KMuriungi/Kithinji-Muriungi-Drone-Project---Final-Year-Engineering-Project/Images/Drone App 53.jpeg

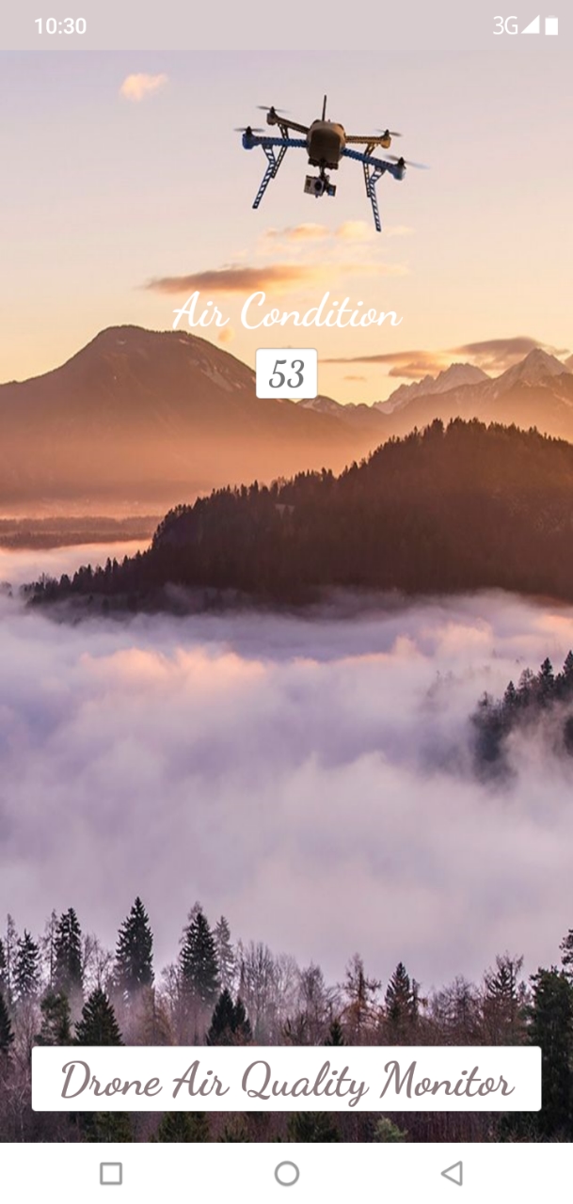
Images/Drone App 53.jpeg
