KMuriungi/Kithinji-Muriungi-Drone-Project---Final-Year-Engineering-Project/Images/Ki.jpg

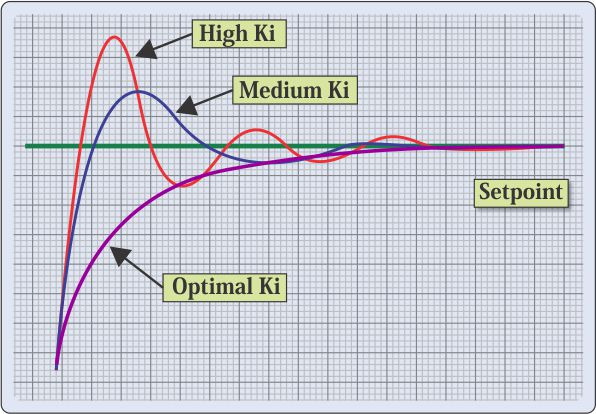
Images/Ki.jpg
