KMuriungi/Kithinji-Muriungi-Drone-Project---Final-Year-Engineering-Project/README.md

# Kithinji-Muriungi-Drone-Project---Final-Year-Engineering-Project

BEng (Electrical & Electronics Engineering)

/*ECE 590: ENGINEERING PROJECT II      
MULTI-PURPOSE QUADCOPTER     
: Arduino Based PID Controller     
EC/09/14  

KITHINJI MURIUNGI  
<WhatsApp: +254718605065, 
Email: kithinjimuriungi@yahoo.com,
https://www.linkedin.com/in/kithinjimuriungi/>  

2018/19     
Supervisor: Mr. S.B.Kifalu */
