KMuriungi/Kithinji-Muriungi-Drone-Project---Final-Year-Engineering-Project/EC-09-14 ECE590 Final Presentation.pdf

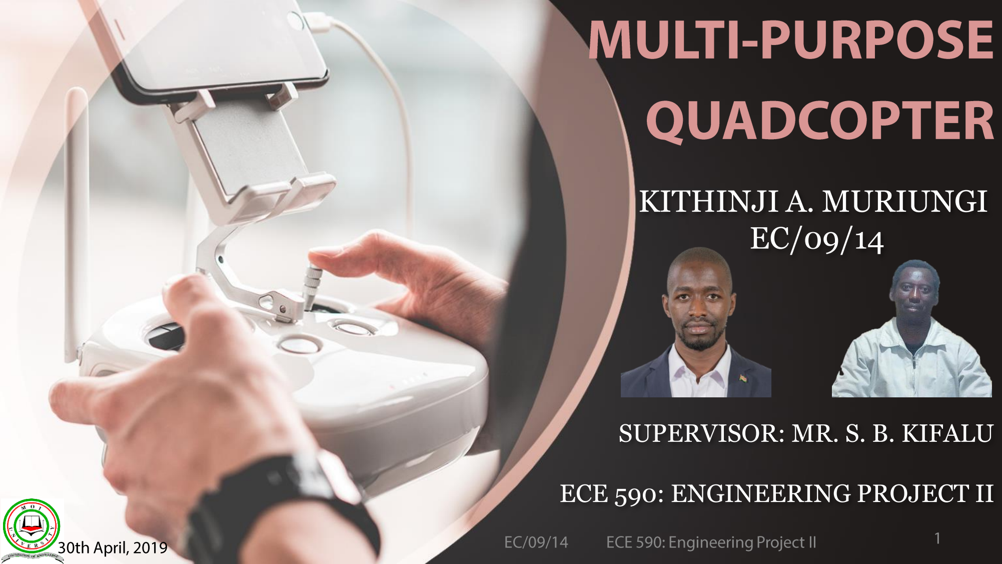
[picture p75: page 1]

KITHINJI A. MURIUNGI
EC/09/14

SUPERVISOR: MR. S. B. KIFALU

ECE 590: ENGINEERING PROJECT II

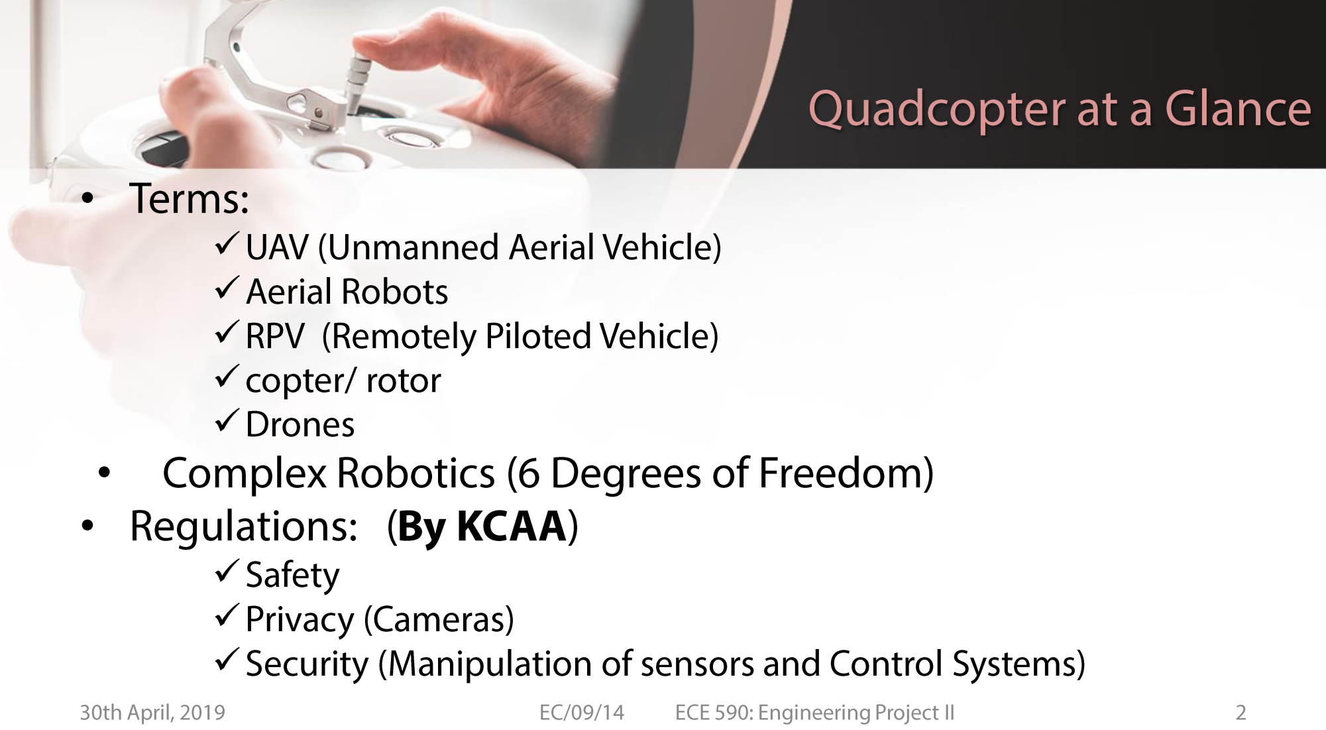
[picture p76: page 2]

•
✓✓✓✓✓

•
•

✓✓✓

- Basic Mechanics (6D of Freedom)
- Design Considerations (Weight, Power, Energy, Mass Distribution)
- Agility (Efficiency and Optimization)
- Components Selection (Frame, Motors & Propellers, Controllers, etc)
- Controls : PID (Height, Thrust)
- Effect of Size and mass
- Applications: IoT-Based

- Surveillance and Border Patrol
- Search and Rescue

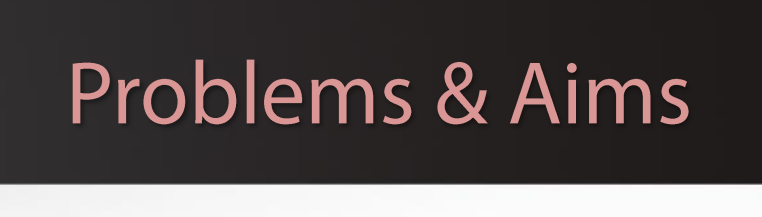
[picture p77: figure]

- First and fast respondent (Danger)
- Access to the most remote and harsh areas
- Expensive and Specific purposed quadcopters
- Manipulation of the existing designs

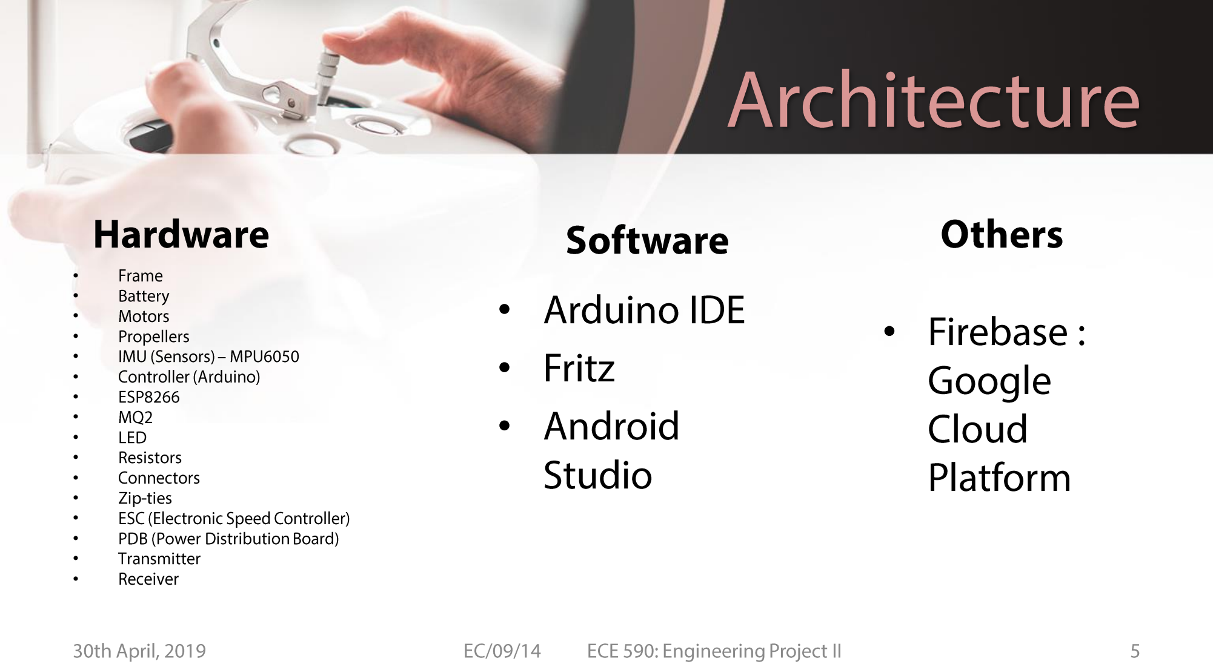
[picture p78: page 5]

••••••••••••••••
•••
•

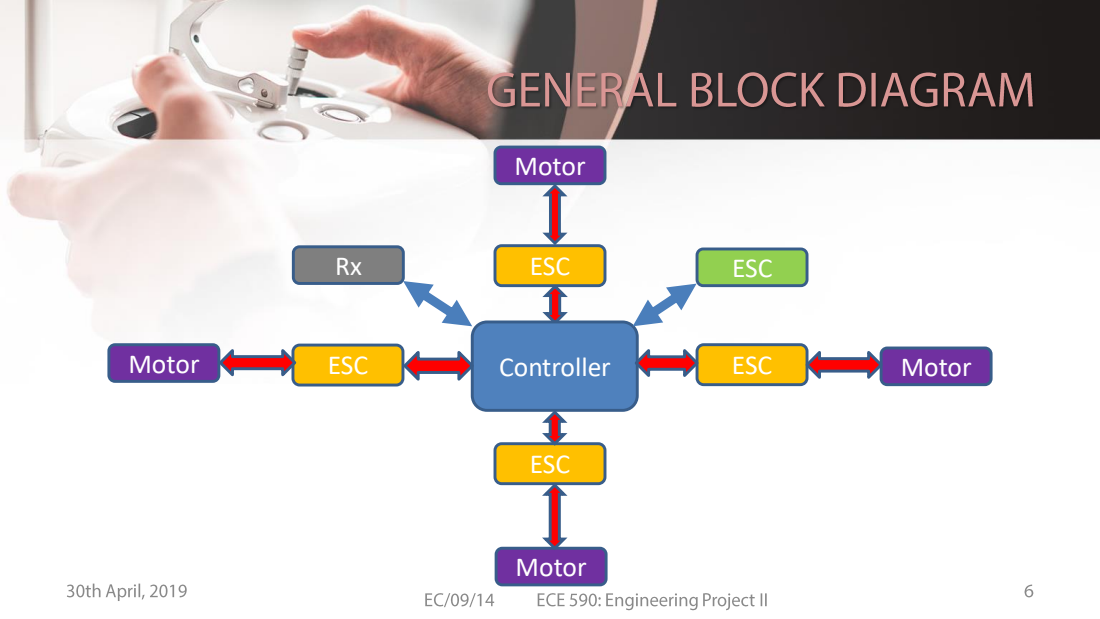
[picture p79: page 6]
ESC; Motor; Controller

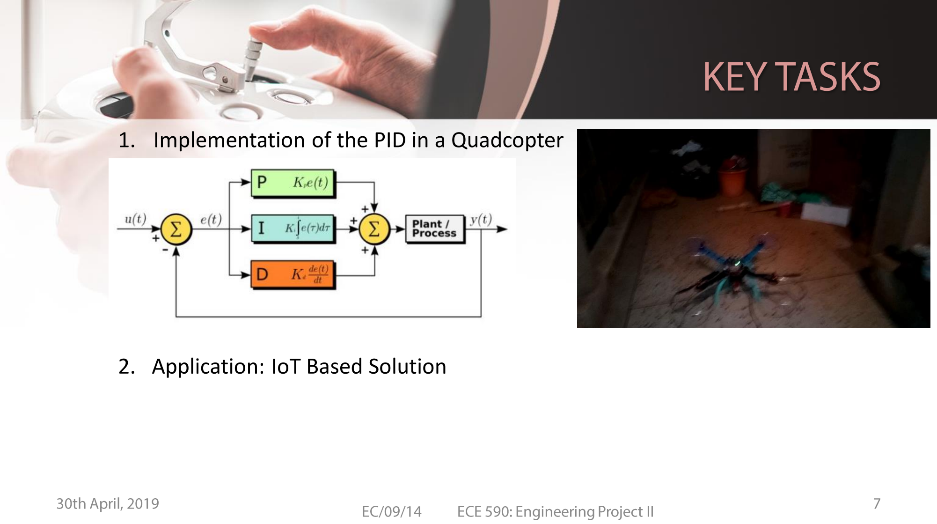
[picture p80: page 7]

1. Implementation of the PID in a Quadcopter
2. Application: IoT Based Solution

- Design Manipulation.
- Precision Building.
- Complex Design Controls.

- Delay of the project.

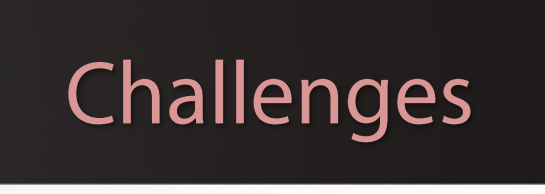
[picture p81: figure]

- Faulty IMU makes it hard in controls.
- Power Problems.
- Obtaining a precise Balanced System.
- Very expensive project.
- Big Scope for one person.

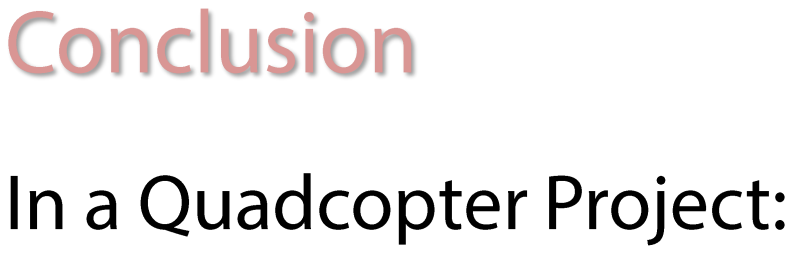
[picture p82: figure]

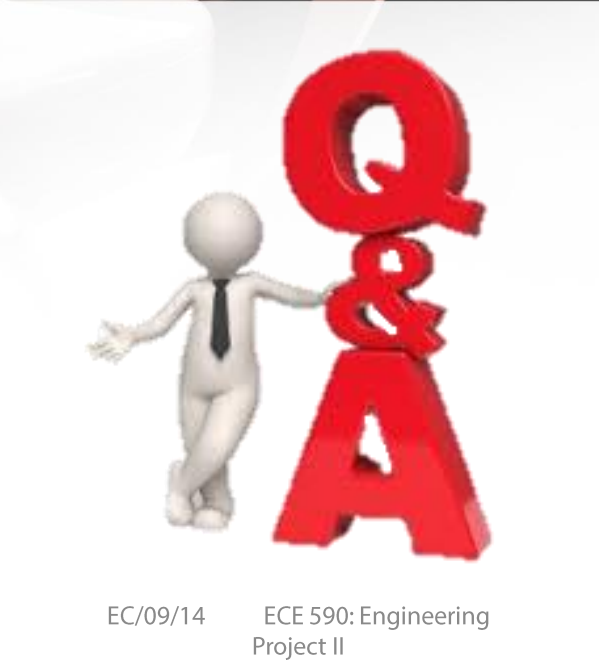
[picture p83: figure]
