KMuriungi/Kithinji-Muriungi-Drone-Project---Final-Year-Engineering-Project/KCAA License.pdf

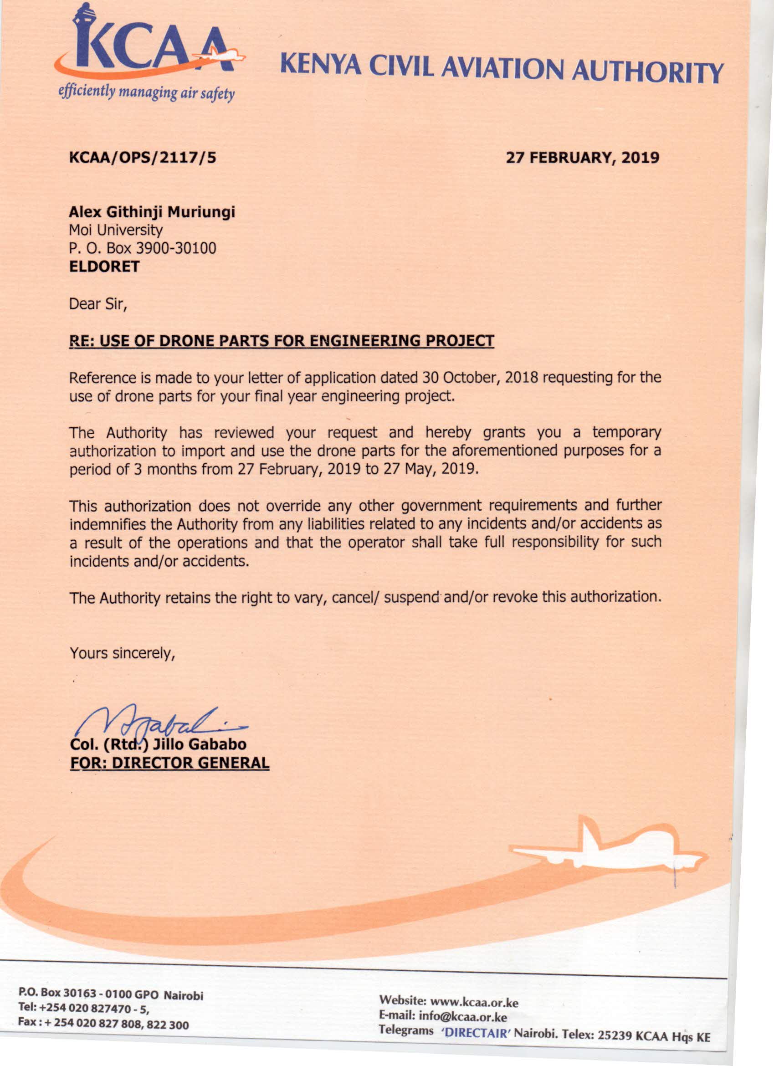
[picture p84: page 1]
