KMuriungi/Kithinji-Muriungi-Drone-Project---Final-Year-Engineering-Project/Images/algorithms/Best Quadcopter Report_017.png

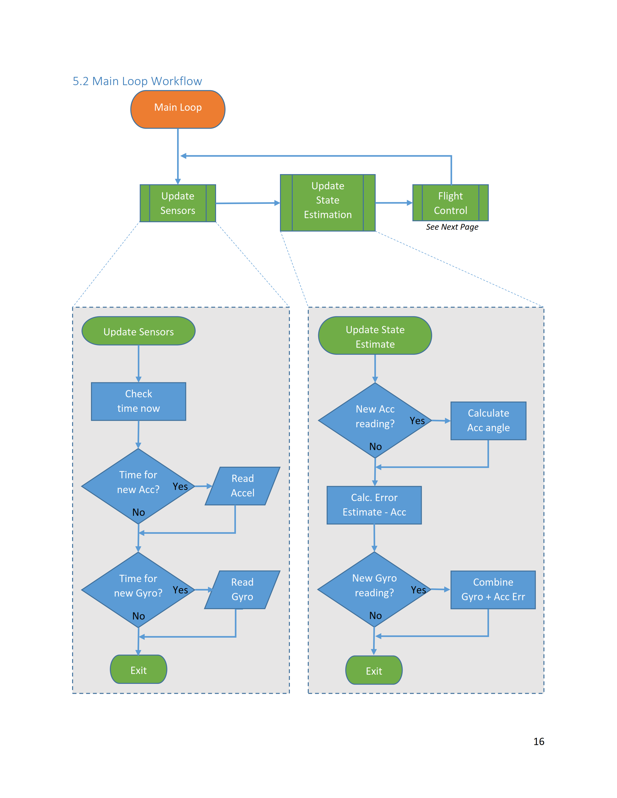
Images/algorithms/Best Quadcopter Report_017.png
