KMuriungi/Kithinji-Muriungi-Drone-Project---Final-Year-Engineering-Project/Images/algorithms/Best Quadcopter Report_019.png

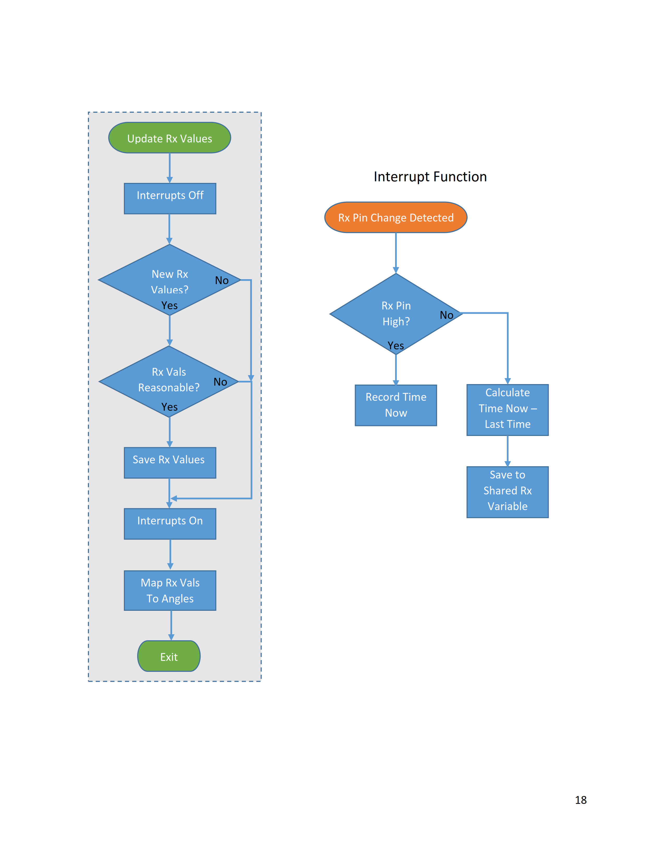
Images/algorithms/Best Quadcopter Report_019.png
