KMuriungi/Kithinji-Muriungi-Drone-Project---Final-Year-Engineering-Project/Images/arducopter.jpg

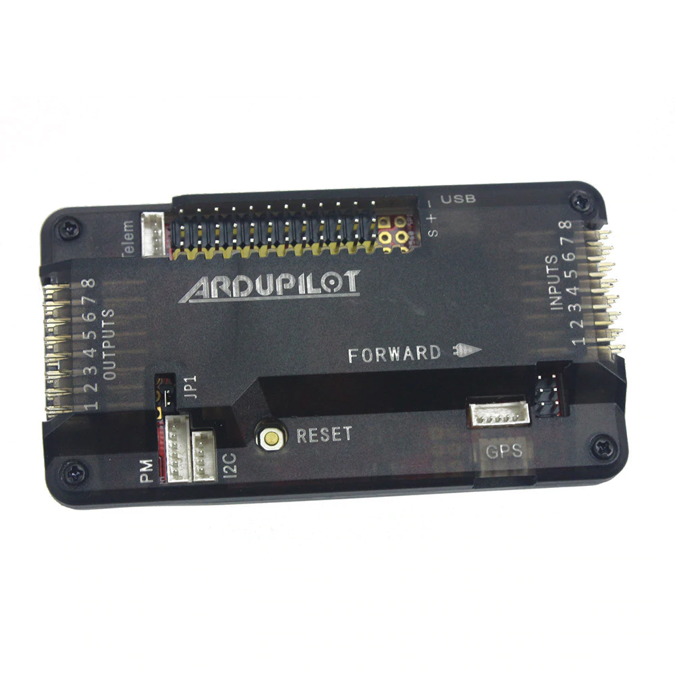
Images/arducopter.jpg
