KMuriungi/Kithinji-Muriungi-Drone-Project---Final-Year-Engineering-Project/Images/arduino uno.jpg

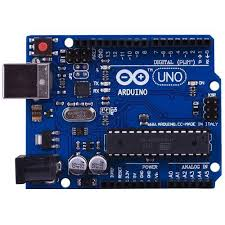
Images/arduino uno.jpg
