KMuriungi/Kithinji-Muriungi-Drone-Project---Final-Year-Engineering-Project/Images/ardupilot.jpg

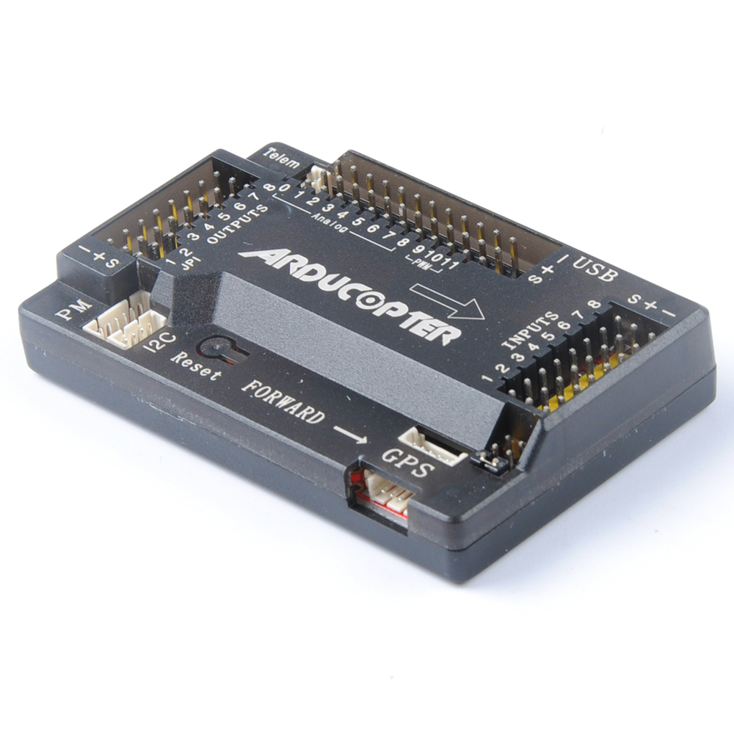
Images/ardupilot.jpg
