KMuriungi/Kithinji-Muriungi-Drone-Project---Final-Year-Engineering-Project/Images/code flow.png

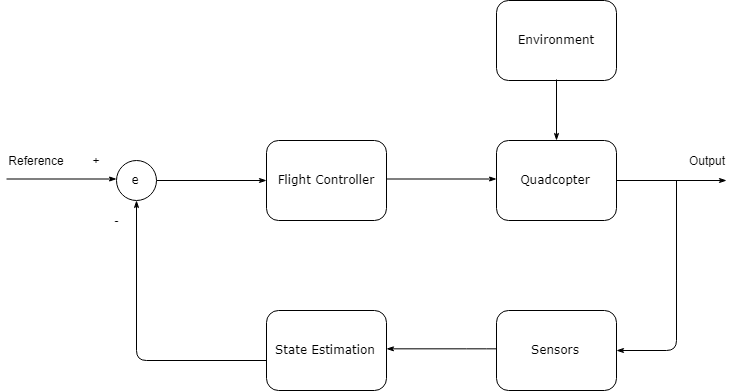
Images/code flow.png
