KMuriungi/Kithinji-Muriungi-Drone-Project---Final-Year-Engineering-Project/Images/esc.jpg

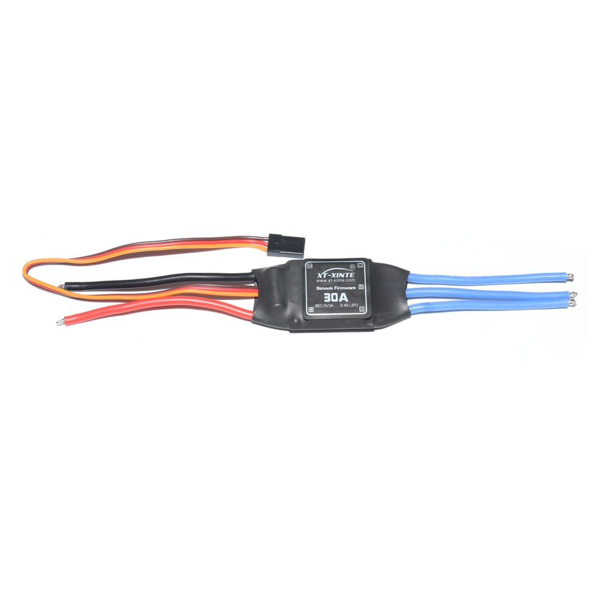
Images/esc.jpg
