KMuriungi/Kithinji-Muriungi-Drone-Project---Final-Year-Engineering-Project/Images/esp8266 fritz.png

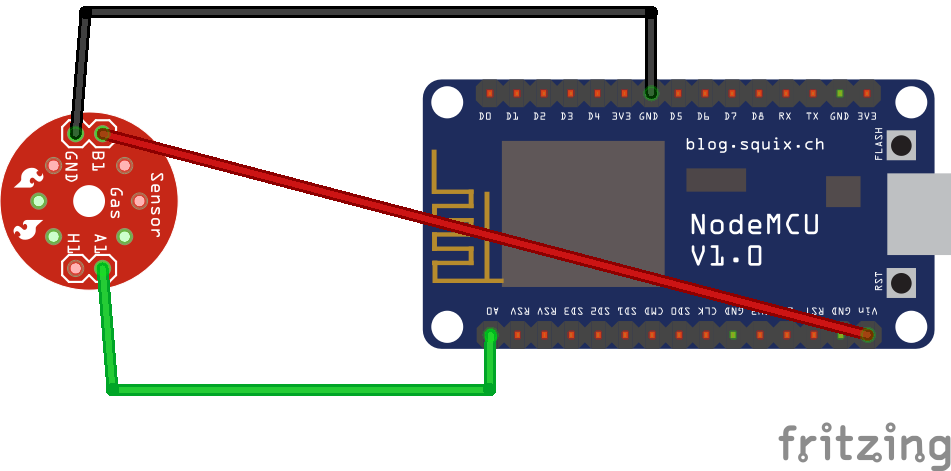
Images/esp8266 fritz.png
