KMuriungi/Kithinji-Muriungi-Drone-Project---Final-Year-Engineering-Project/Images/flysky transmitter.jpg

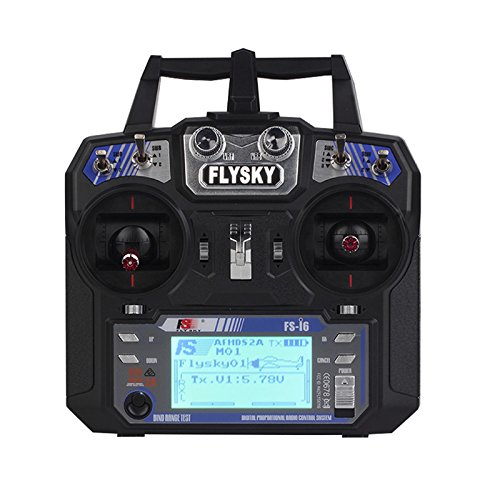
Images/flysky transmitter.jpg
