KMuriungi/Kithinji-Muriungi-Drone-Project---Final-Year-Engineering-Project/Images/frame whole.jpg

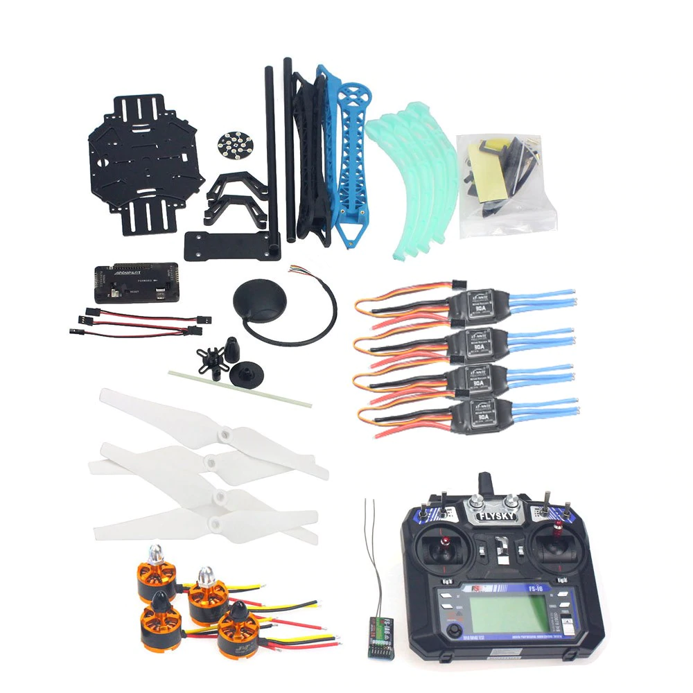
Images/frame whole.jpg
