KMuriungi/Kithinji-Muriungi-Drone-Project---Final-Year-Engineering-Project/Images/kp kd.jpg

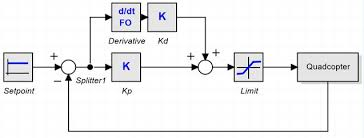
Images/kp kd.jpg
