KMuriungi/Kithinji-Muriungi-Drone-Project---Final-Year-Engineering-Project/Images/MPU-6050 Arduino_bb.png

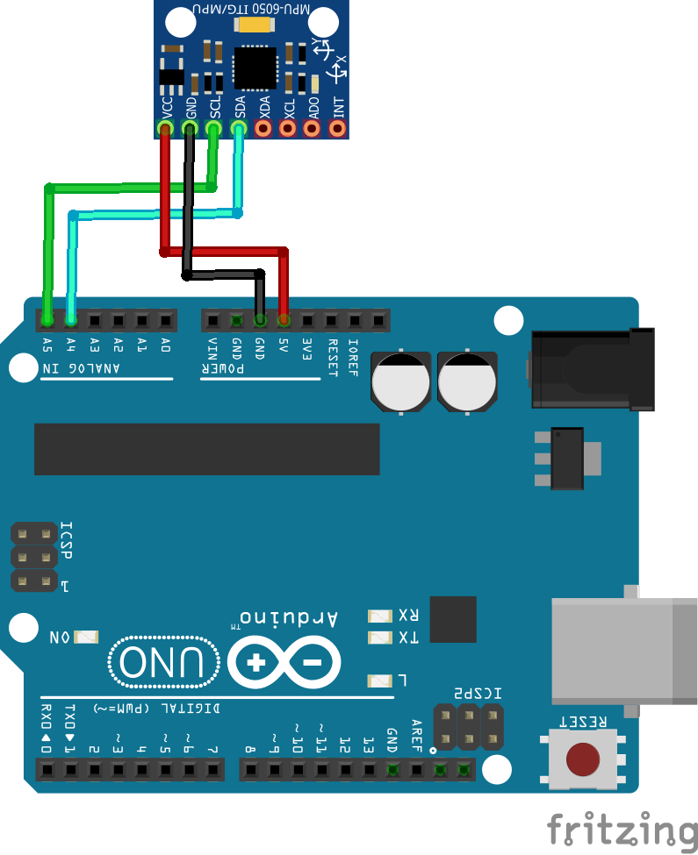
Images/MPU-6050 Arduino_bb.png
