KMuriungi/Kithinji-Muriungi-Drone-Project---Final-Year-Engineering-Project/Images/mq2-sensor.png

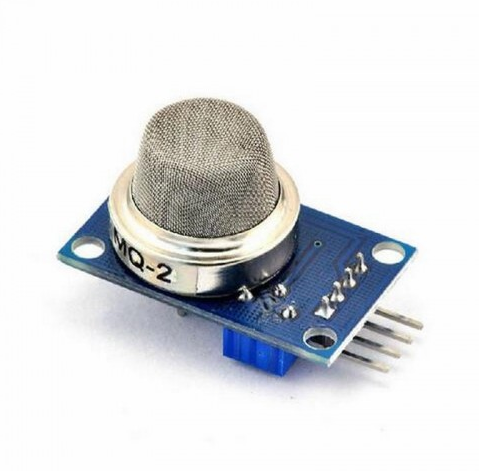
Images/mq2-sensor.png
