KMuriungi/Kithinji-Muriungi-Drone-Project---Final-Year-Engineering-Project/Images/pd flow.png

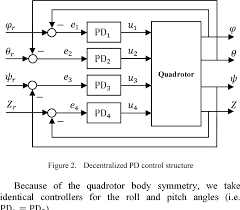
Images/pd flow.png
