KMuriungi/Kithinji-Muriungi-Drone-Project---Final-Year-Engineering-Project/Images/pd height control 3 color.jpg

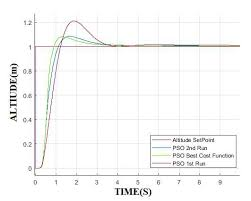
Images/pd height control 3 color.jpg
