KMuriungi/Kithinji-Muriungi-Drone-Project---Final-Year-Engineering-Project/Images/pd height control.png

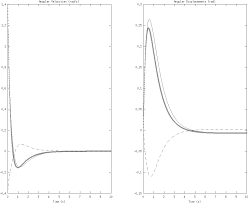
Images/pd height control.png
