KMuriungi/Kithinji-Muriungi-Drone-Project---Final-Year-Engineering-Project/Images/PLAGIARISM.PNG

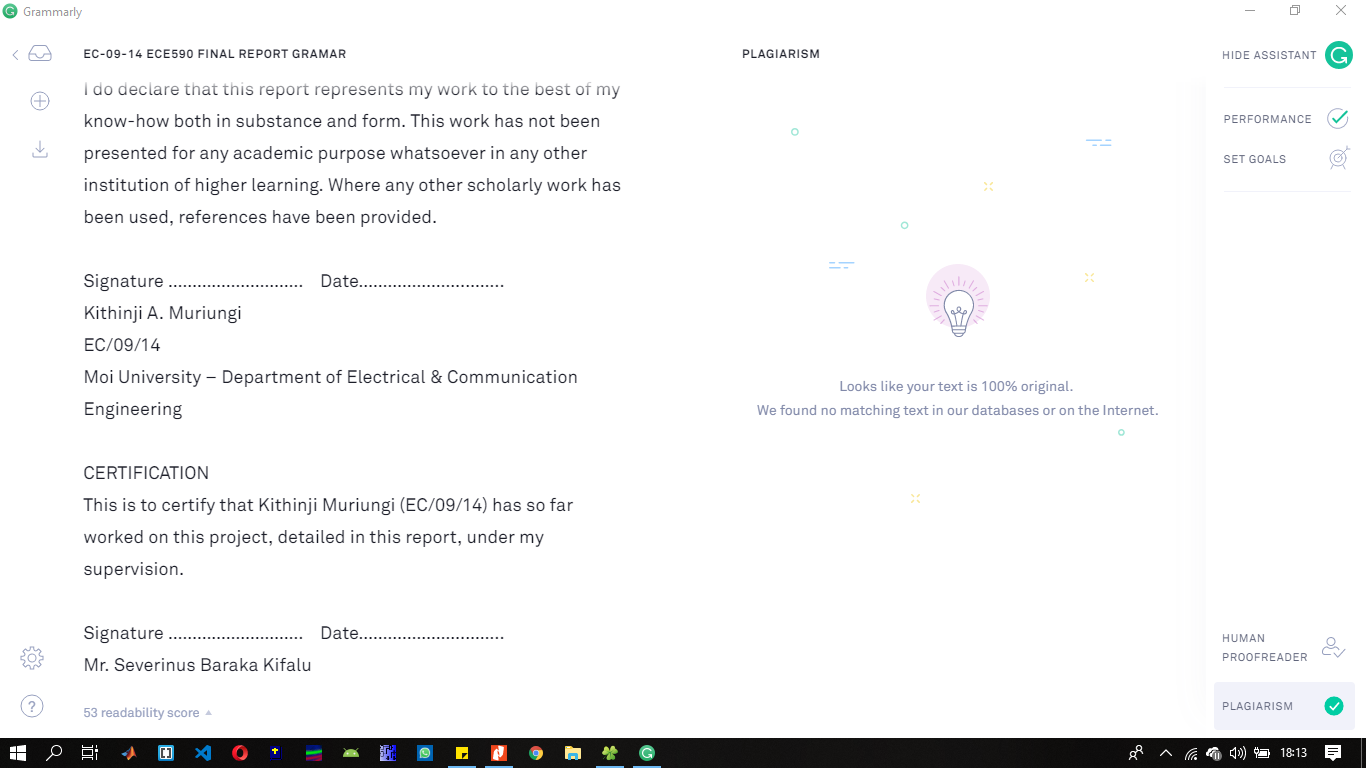
Images/PLAGIARISM.PNG
