KMuriungi/Kithinji-Muriungi-Drone-Project---Final-Year-Engineering-Project/Images/Quad fritz_bb.png

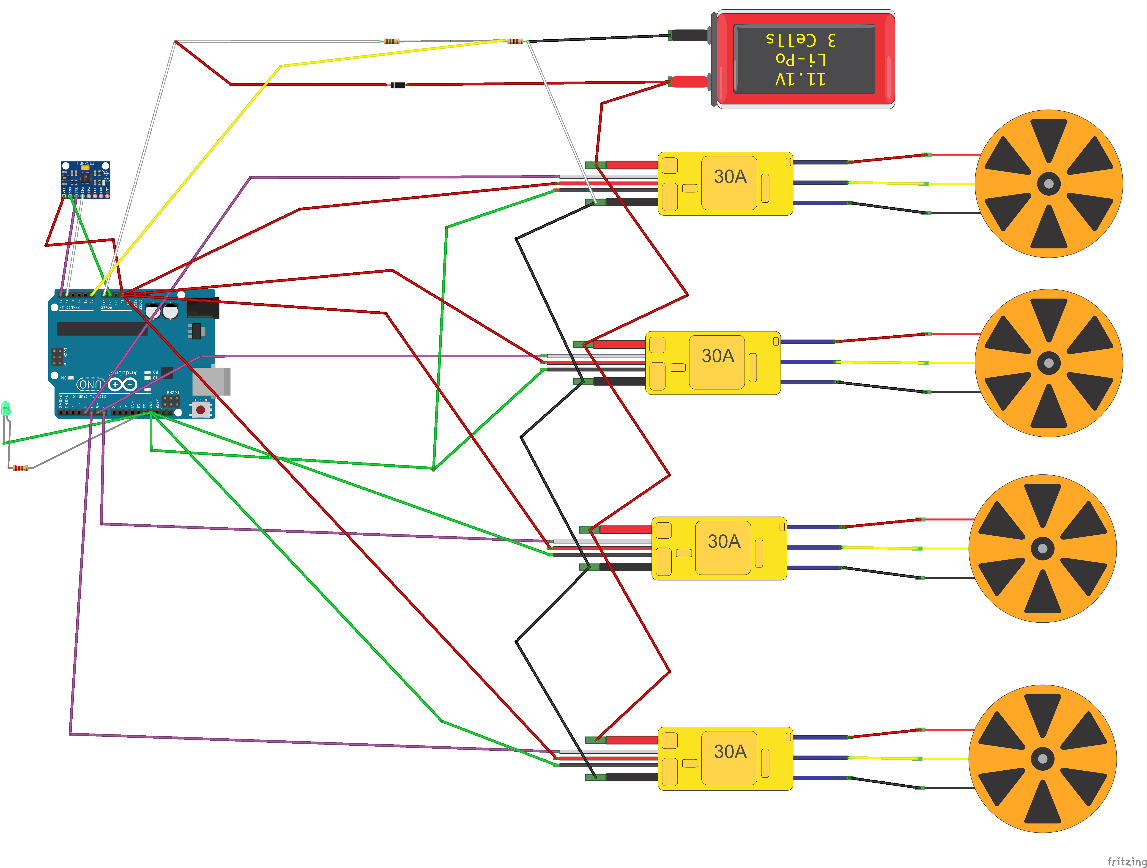
Images/Quad fritz_bb.png
