KMuriungi/Kithinji-Muriungi-Drone-Project---Final-Year-Engineering-Project/Images/quadcopter-propeller-thrust.png

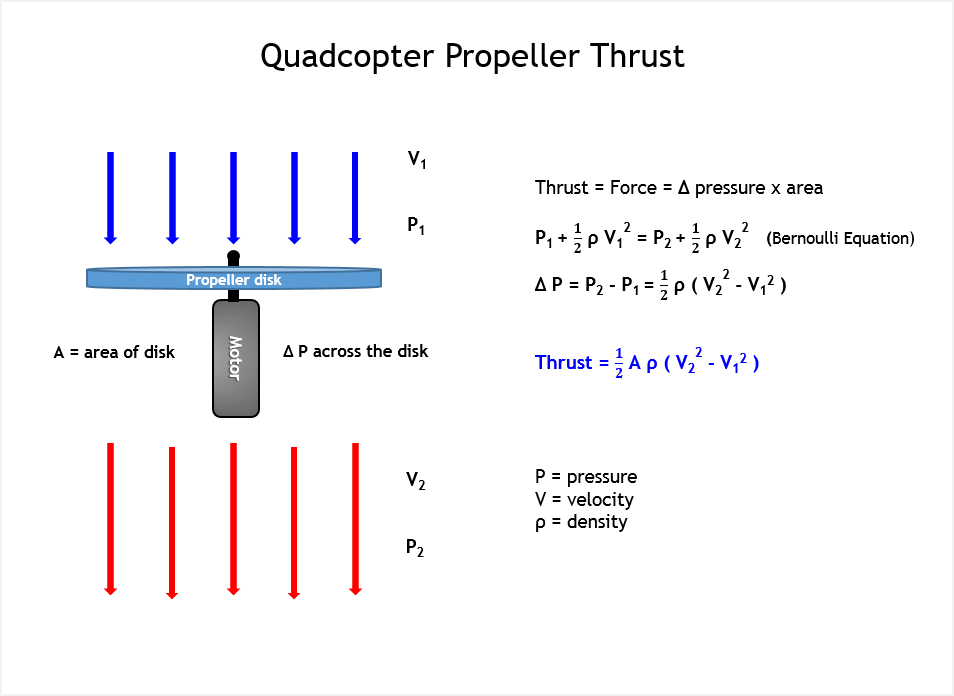
Images/quadcopter-propeller-thrust.png
