KMuriungi/Kithinji-Muriungi-Drone-Project---Final-Year-Engineering-Project/Images/rx tx.jpg

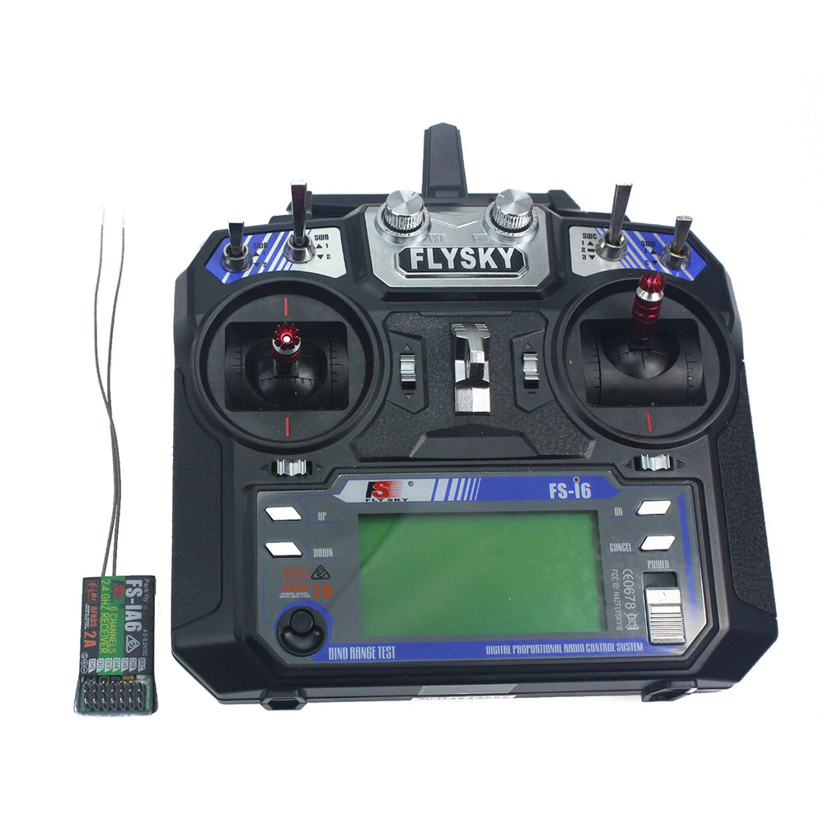
Images/rx tx.jpg
