KMuriungi/Kithinji-Muriungi-Drone-Project---Final-Year-Engineering-Project/Images/schedule.PNG

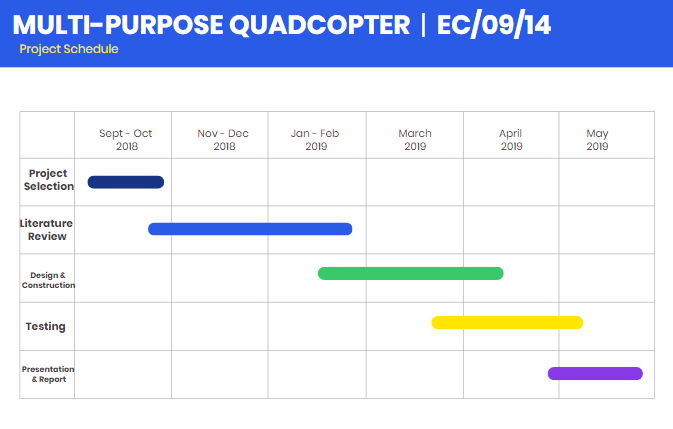
Images/schedule.PNG
