KMuriungi/Kithinji-Muriungi-Drone-Project---Final-Year-Engineering-Project/Images/thrust to weight.png

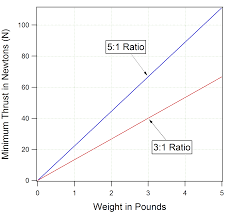
Images/thrust to weight.png
