KMuriungi/Kithinji-Muriungi-Drone-Project---Final-Year-Engineering-Project/Images/thrust weight.jpg

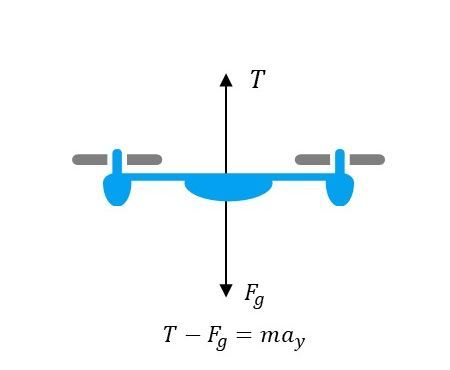
Images/thrust weight.jpg
