KMuriungi/Kithinji-Muriungi-Drone-Project---Final-Year-Engineering-Project/Images/thrust,yaw, roll,pitch.png

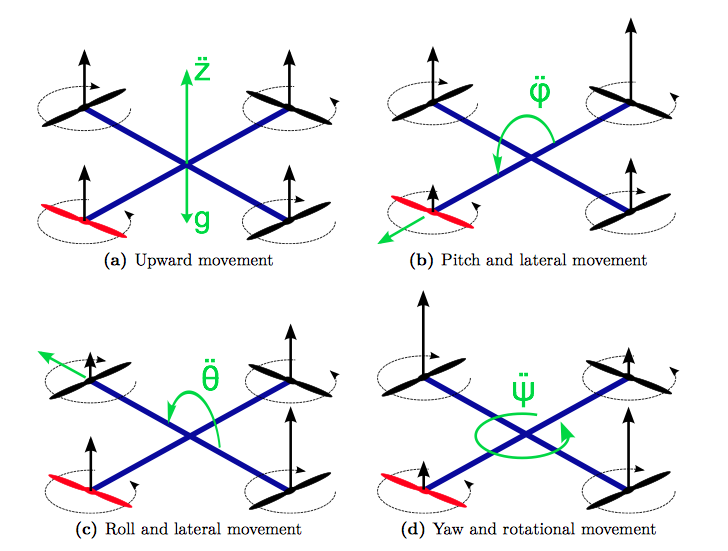
Images/thrust,yaw, roll,pitch.png
