KMuriungi/Kithinji-Muriungi-Drone-Project---Final-Year-Engineering-Project/My Report Resources/Gyro Pitch Error 0001.JPG

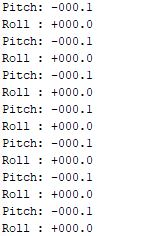
My Report Resources/Gyro Pitch Error 0001.JPG
