KMuriungi/Kithinji-Muriungi-Drone-Project---Final-Year-Engineering-Project/My Report Resources/firebase Arduino Setup.JPG

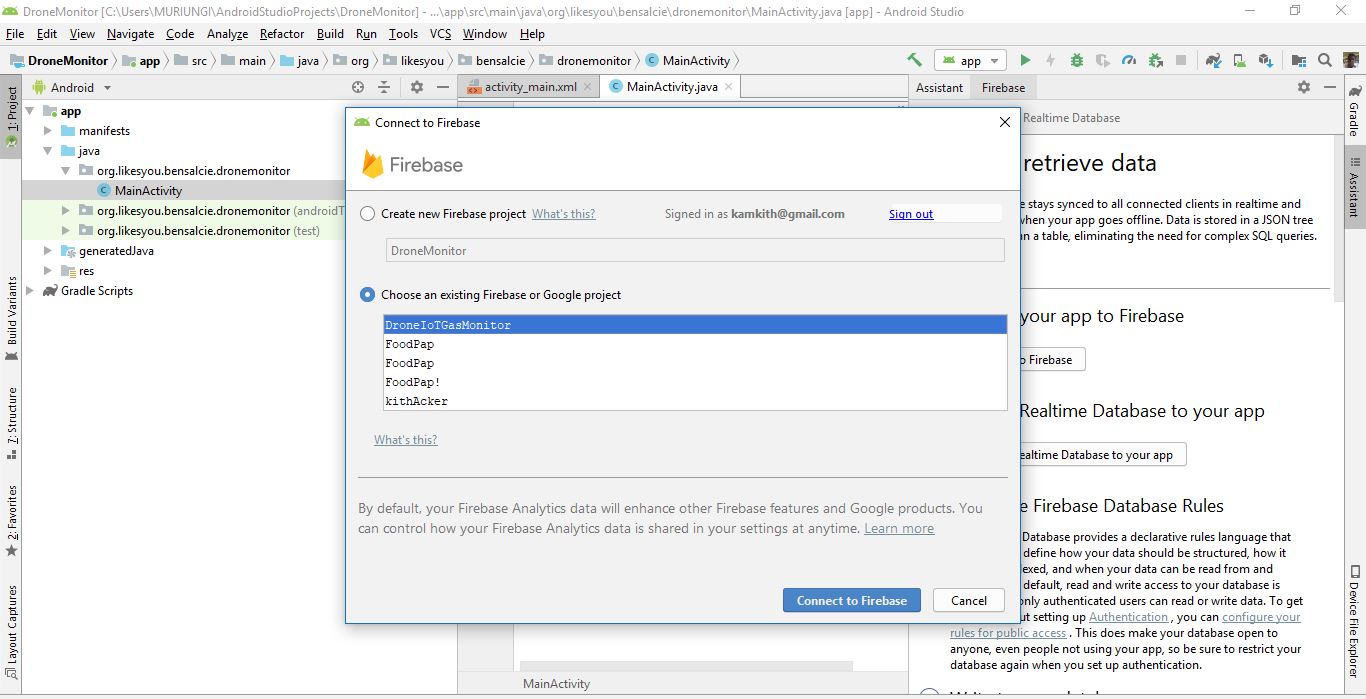
My Report Resources/firebase Arduino Setup.JPG
